JonathSpirit/Gmic/images/DS0001.PNG

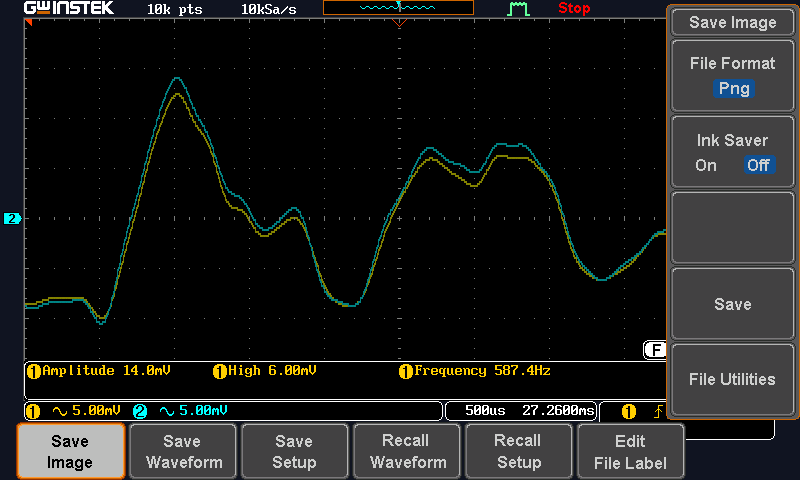
images/DS0001.PNG
