JonathSpirit/Gmic/images/DS0002.PNG

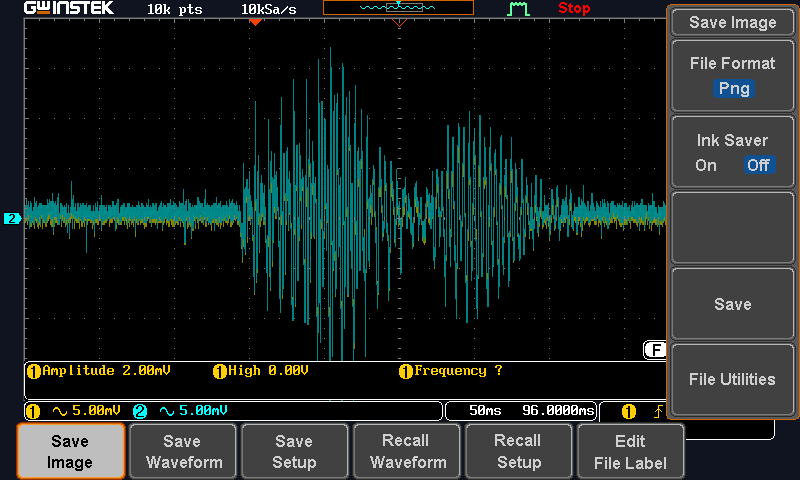
images/DS0002.PNG
