JonathSpirit/Gmic/images/DS0003.PNG

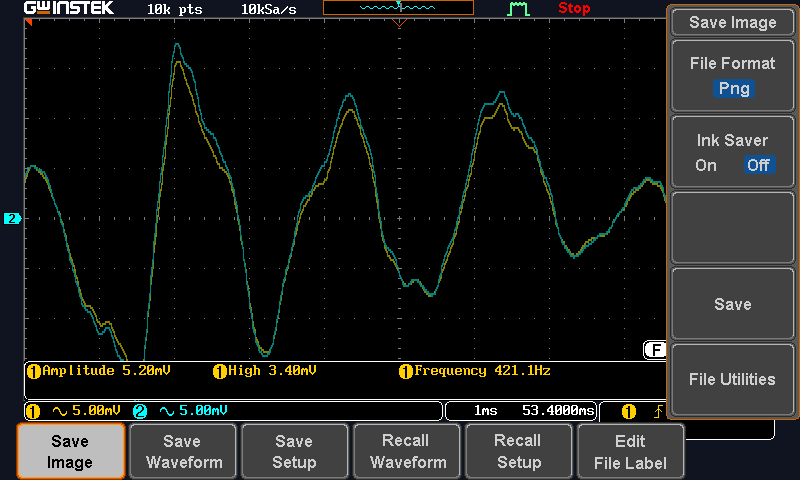
images/DS0003.PNG
