JonathSpirit/Gmic/docs/PCB_BOT.pdf

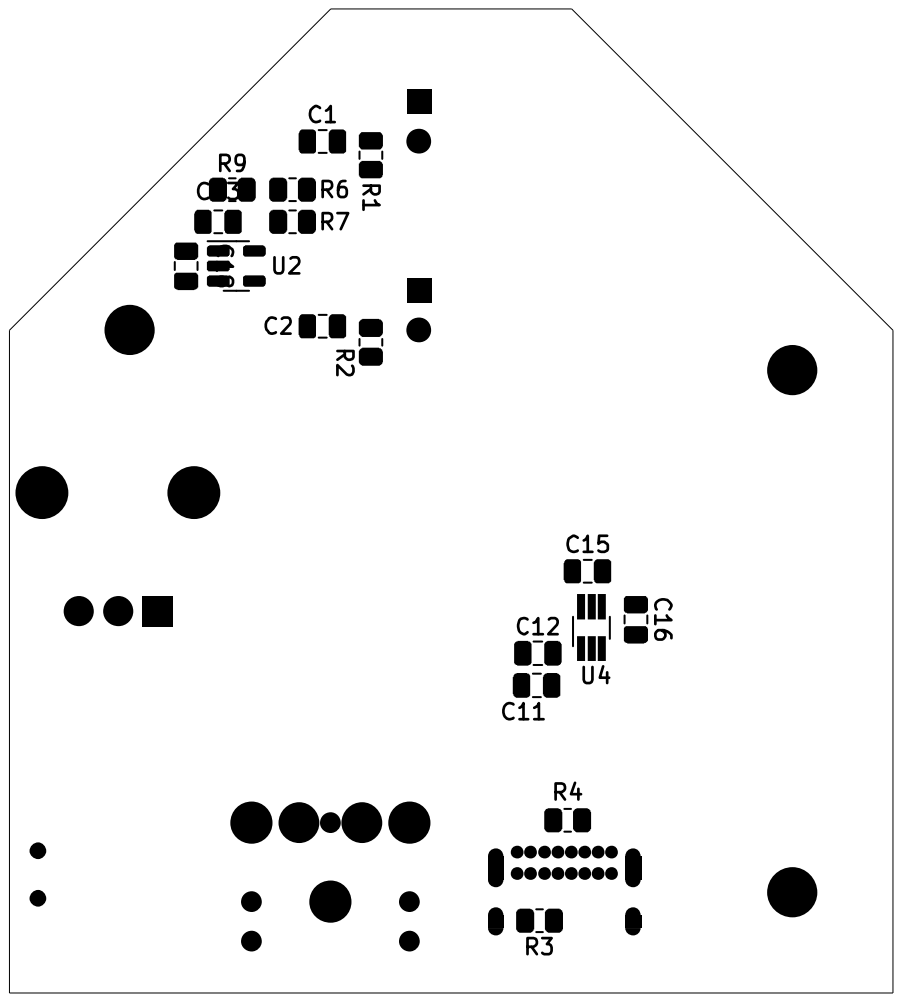
[picture p4: page 1]
