JonathSpirit/Gmic/docs/PCB_TOP.pdf

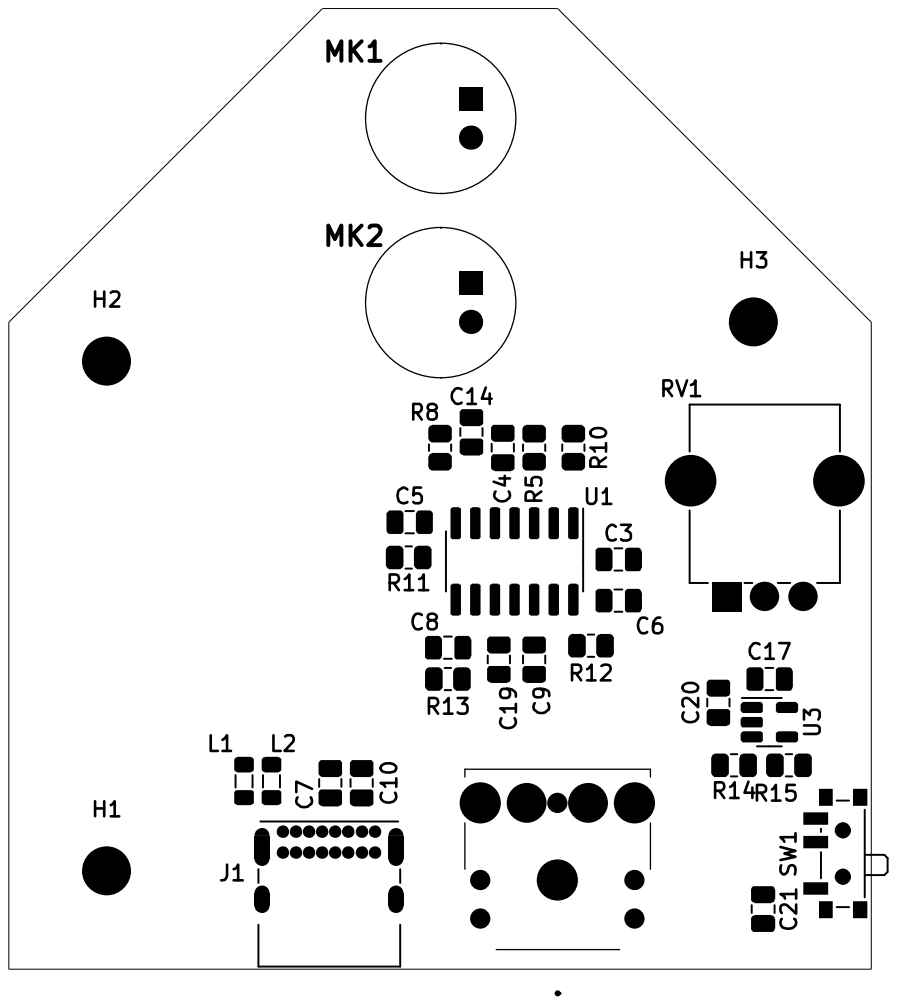
[picture p5: page 1]
