JonathSpirit/Gmic/simulations/Simulation.asc

C1: cap; 2.2µF
C2: cap; 100pF
C3: cap; 100pF
C4: cap; 100pF
C5: cap; 2.2µF
C6: cap; 2.2µF
C7: cap; 2.2µF
C8: cap; 100nF
C9: cap; 100nF
G1: g; 2.87µ
G2: g; 2.87µ
R1: res; 100k
R2: res; 100k
R3: res; 50k
R4: res; 2.2k
R5: res; 100k
R6: res; 10k
R7: res; 100k
R8: res; 10k
R9: res; 2.2k
R10: res; 80k
R11: res; 80k
R12: res; 80k
R13: res; {RPOT}
R14: res; 80k
R15: res; 80k
U1: AD8531
U2: AD8531
U3: AD8531
U4: AD8531
U5: AD8531
U6: AD8531
U7: AD8531
V3: voltage; 3.3V
V5: voltage; 62V
V6: voltage; SINE(0 0.5 10k); AC 0.5
V7: voltage; 62V
V8: voltage; SINE(0 0.45 10k); AC 0.5
Named nets: 0, Vcc, AudioCurrentIn1, AudioCurrentIn2, Vss, VOffset, AudioAverage, AudioLowPassFilter, AudioHighPassFilter, AudioOut
.tran 0 1ms 0
;ac dec 100 1 1000000
CMC-9745-44P
CMC-9745-44P
1Meg should be great, but the bandwidth of the AOP (3MHz) is limiting us
Pre-amp stage (current to voltage)
Audio averaging
Low-pass filter 20kHz, 3 order
Simple Vcc/2 reference for offset
High-pass filter 20Hz, 2 order
We already have here a ~20Hz+-20Hz high-pass at the microphone output
.step oct param RPOT 0 500k 10
