JonathSpirit/Gmic/Project_Gmic.kicad_pcb

## KiCad design Project_Gmic.kicad_pcb (2024-10-31)

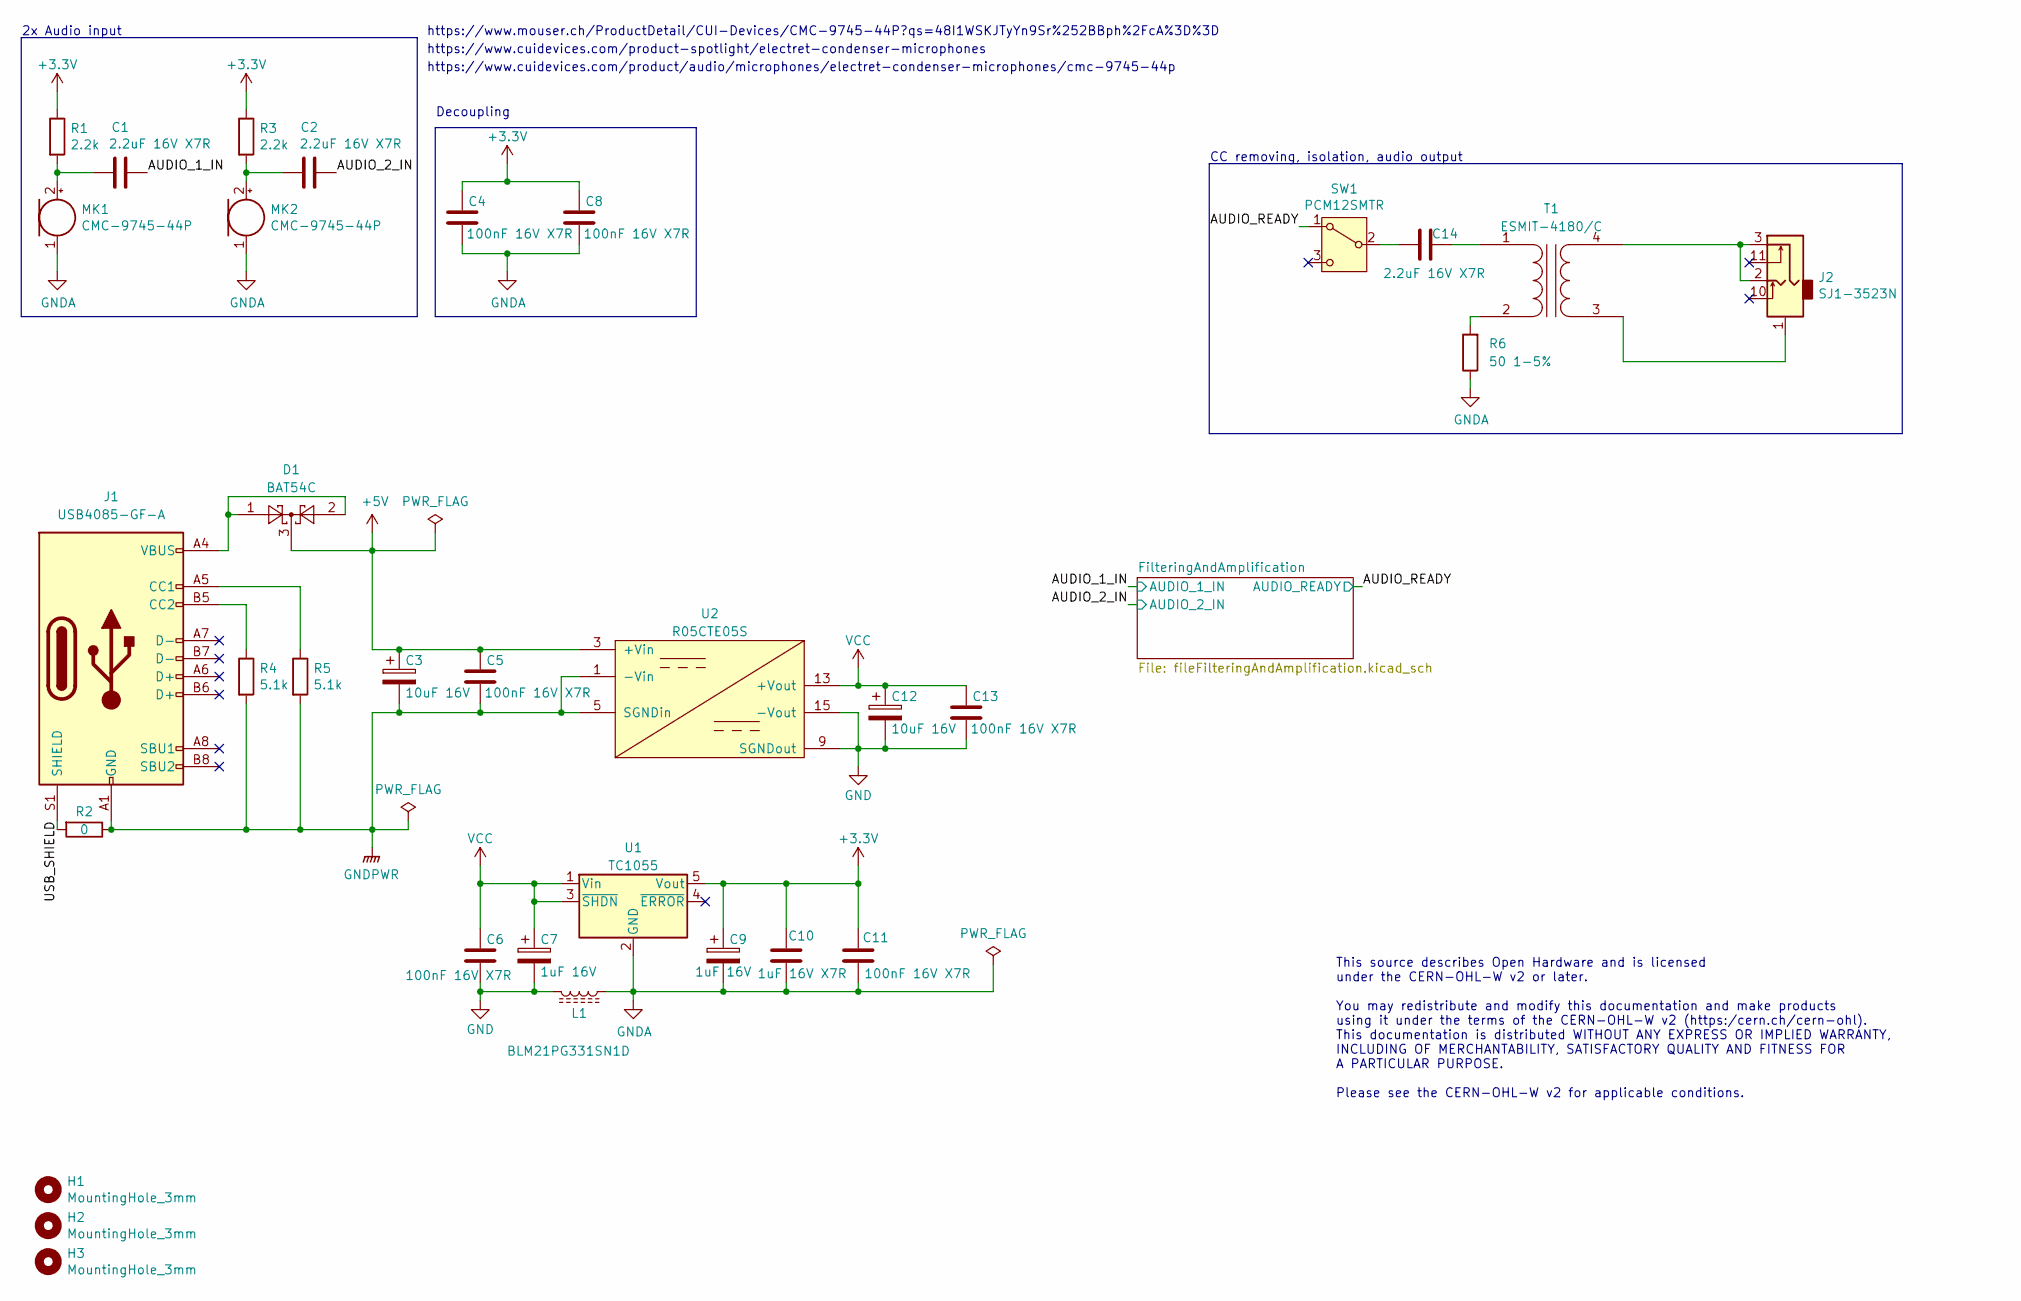
[picture p6: schematic Project_Gmic.kicad_sch, Gmic]

Parts:
C1, C2, C14: 2.2uF 16V X7R; C_0805_2012Metric
C3, C12: 10uF 16V; CP_Elec_4x5.4
C4, C5, C6, C8, C11, C13: 100nF 16V X7R; C_0805_2012Metric
C7, C9: 1uF 16V; CP_Elec_4x5.4
C10: 1uF 16V X7R; C_0805_2012Metric
D1: BAT54C; SOT-23
H1, H2, H3: MountingHole_3mm
J1: USB4085-GF-A; USB_C_Receptacle_GCT_USB4085
J2: SJ1-3523N; SJ13523N
L1: BLM21PG331SN1D; L_0805_2012Metric
MK1, MK2: CMC-9745-44P; CMC974544P
R1, R3: 2.2k; R_0805_2012Metric
R2: 0; R_0805_2012Metric
R4, R5: 5.1k; R_0805_2012Metric
R6: 50 1-5%; R_0805_2012Metric
SW1: PCM12SMTR; SW_SPDT_PCM12
T1: ESMIT-4180/C; SOP254P914X350-4N
U1: TC1055; SOT-23-5
U2: R05CTE05S; SOIC-16W_7.5x10.3mm_P1.27mm

Connections:
+3.3V: C4.1, C8.1, C9.1, C10.1, C11.1, R1.1, R3.1, U1.5 (Vout); also elsewhere on the board
+5V: C3.1, C5.1, D1.3, U2.3 (+Vin), U2.4 (+Vin)
/AUDIO_1_IN: C1.1; also elsewhere on the board
/AUDIO_2_IN: C2.1; also elsewhere on the board
/AUDIO_READY: SW1.1 (A); also elsewhere on the board
/USB_SHIELD: J1.S1 (SHIELD), R2.2
GND: C6.2, C7.2, C12.2, C13.2, L1.2, U2.9 (SGNDout), U2.11 (SGNDout), U2.12 (SGNDout), U2.15 (-Vout), U2.16 (-Vout)
GNDA: C4.2, C8.2, C9.2, C10.2, C11.2, L1.1, MK1.1 (-), MK2.1 (-), R6.1, U1.2 (GND); also elsewhere on the board
GNDPWR: C3.2, C5.2, J1.A1 (GND), J1.A12 (GND), J1.B1 (GND), J1.B12 (GND), R2.1, R4.2, R5.2, U2.1 (-Vin), U2.2 (-Vin), U2.5 (SGNDin), U2.6 (SGNDin), U2.7 (SGNDin), U2.8 (SGNDin)
unnamed: D1.1, D1.2, J1.A4 (VBUS), J1.A9 (VBUS), J1.B4 (VBUS), J1.B9 (VBUS)
unnamed: J1.A5 (CC1), R5.1
unnamed: J1.B5 (CC2), R4.1
unnamed: C1.2, MK1.2 (+), R1.2
unnamed: C2.2, MK2.2 (+), R3.2
unnamed: C14.2, SW1.2 (B)
unnamed: C14.1, T1.1 (AA)
unnamed: R6.2, T1.2 (AB)
unnamed: J2.1, T1.3 (SA)
unnamed: J2.2, J2.3, T1.4 (SB)
VCC: C6.1, C7.1, C12.1, C13.1, U1.1 (Vin), U1.3 (~SHDN), U2.13 (+Vout), U2.14 (+Vout)

Notes on the sheet:
https://www.mouser.ch/ProductDetail/CUI-Devices/CMC-9745-44P?qs=48I1WSKJTyYn9Sr%252BBph%2FcA%3D%3D
CC removing, isolation, audio output
https://www.cuidevices.com/product/audio/microphones/electret-condenser-microphones/cmc-9745-44p
Decoupling
https://www.cuidevices.com/product-spotlight/electret-condenser-microphones
2x Audio input
This source describes Open Hardware and is licensed under the CERN-OHL-W v2 or later. You may redistribute and modify this documentation and make products using it under the terms of the CERN-OHL-W v2 (https:/cern.ch/cern-ohl). This documentation is distributed WITHOUT ANY EXPRESS OR IMPLIED WARRAN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

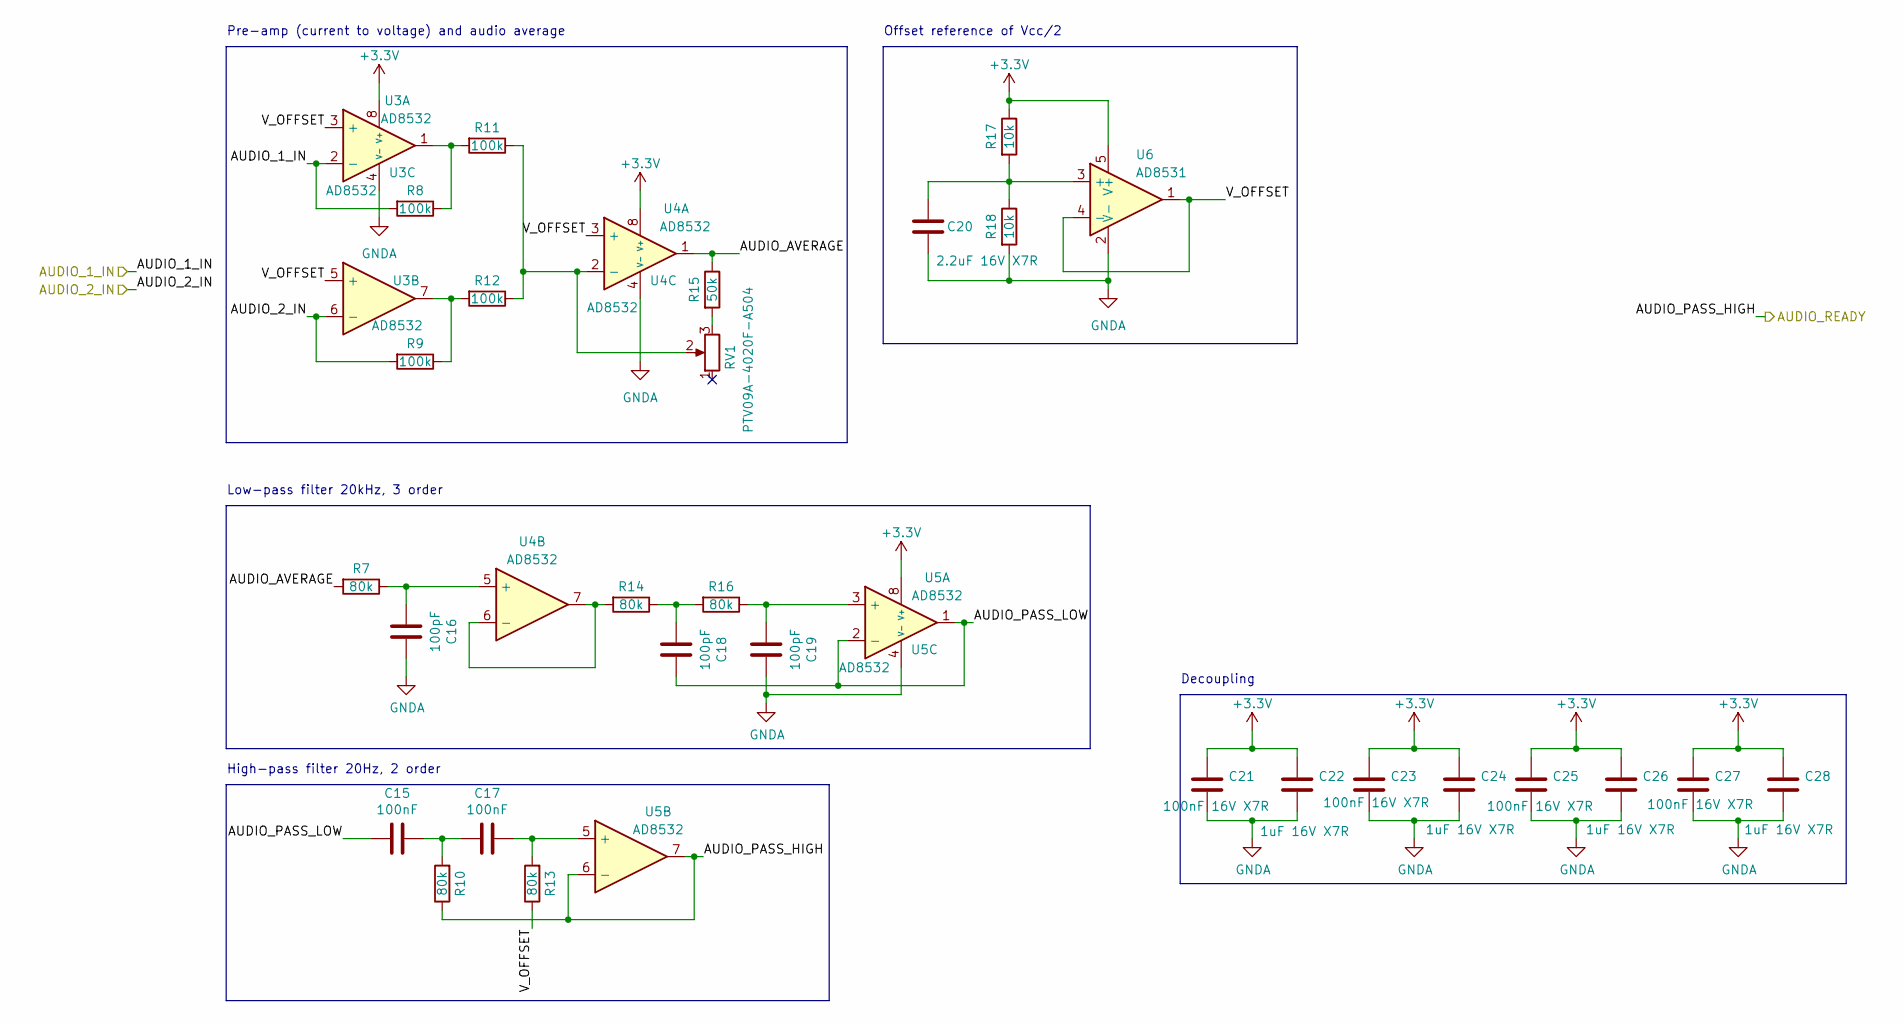
[picture p7: schematic fileFilteringAndAmplification.kicad_sch, Gmic]

Parts:
C15, C17: 100nF; C_1206_3216Metric
C16, C18, C19: 100pF; C_0805_2012Metric
C20: 2.2uF 16V X7R; C_0805_2012Metric
C21, C23, C25, C27: 100nF 16V X7R; C_0805_2012Metric
C22, C24, C26, C28: 1uF 16V X7R; C_0805_2012Metric
R7, R10, R13, R14, R16: 80k; R_0805_2012Metric
R8, R9, R11, R12: 100k; R_0805_2012Metric
R15: 50k; R_0805_2012Metric
R17, R18: 10k; R_0805_2012Metric
RV1: PTV09A-4020F-A504; PTV09A-4
U3, U4, U5: AD8532; SOIC-8_3.9x4.9mm_P1.27mm
U6: AD8531; SOT-23-5

Connections:
+3.3V: C21.1, C22.1, C23.1, C24.1, C25.1, C26.1, C27.1, C28.1, R17.1, U3.8 (V+), U4.8 (V+), U5.8 (V+), U6.5 (V+); also elsewhere on the board
/AUDIO_1_IN: R8.2, U3.2 (-); also elsewhere on the board
/AUDIO_2_IN: R9.2, U3.6 (-); also elsewhere on the board
/AUDIO_READY: R10.1, U5.6 (-), U5.7; also elsewhere on the board
/FilteringAndAmplification/AUDIO_AVERAGE: R7.2, R15.1, U4.1
/FilteringAndAmplification/AUDIO_PASS_LOW: C15.2, C18.1, U5.1, U5.2 (-)
/FilteringAndAmplification/V_OFFSET: R13.1, U3.3 (+), U3.5 (+), U4.3 (+), U6.1, U6.4 (-)
GNDA: C16.1, C19.1, C20.2, C21.2, C22.2, C23.2, C24.2, C25.2, C26.2, C27.2, C28.2, R18.2, U3.4 (V-), U4.4 (V-), U5.4 (V-), U6.2 (V-); also elsewhere on the board
unnamed: C15.1, C17.2, R10.2
unnamed: C18.2, R14.1, R16.2
unnamed: R8.1, R11.2, U3.1
unnamed: R9.1, R12.2, U3.7
unnamed: R15.2, RV1.3
unnamed: R11.1, R12.1, RV1.2, U4.2 (-)
unnamed: C16.2, R7.1, U4.5 (+)
unnamed: R14.2, U4.6 (-), U4.7
unnamed: C19.2, R16.1, U5.3 (+)
unnamed: C17.1, R13.2, U5.5 (+)
unnamed: C20.1, R17.2, R18.1, U6.3 (+)

Notes on the sheet:
Decoupling
High-pass filter 20Hz, 2 order
Pre-amp (current to voltage) and audio average
Low-pass filter 20kHz, 3 order
Offset reference of Vcc/2

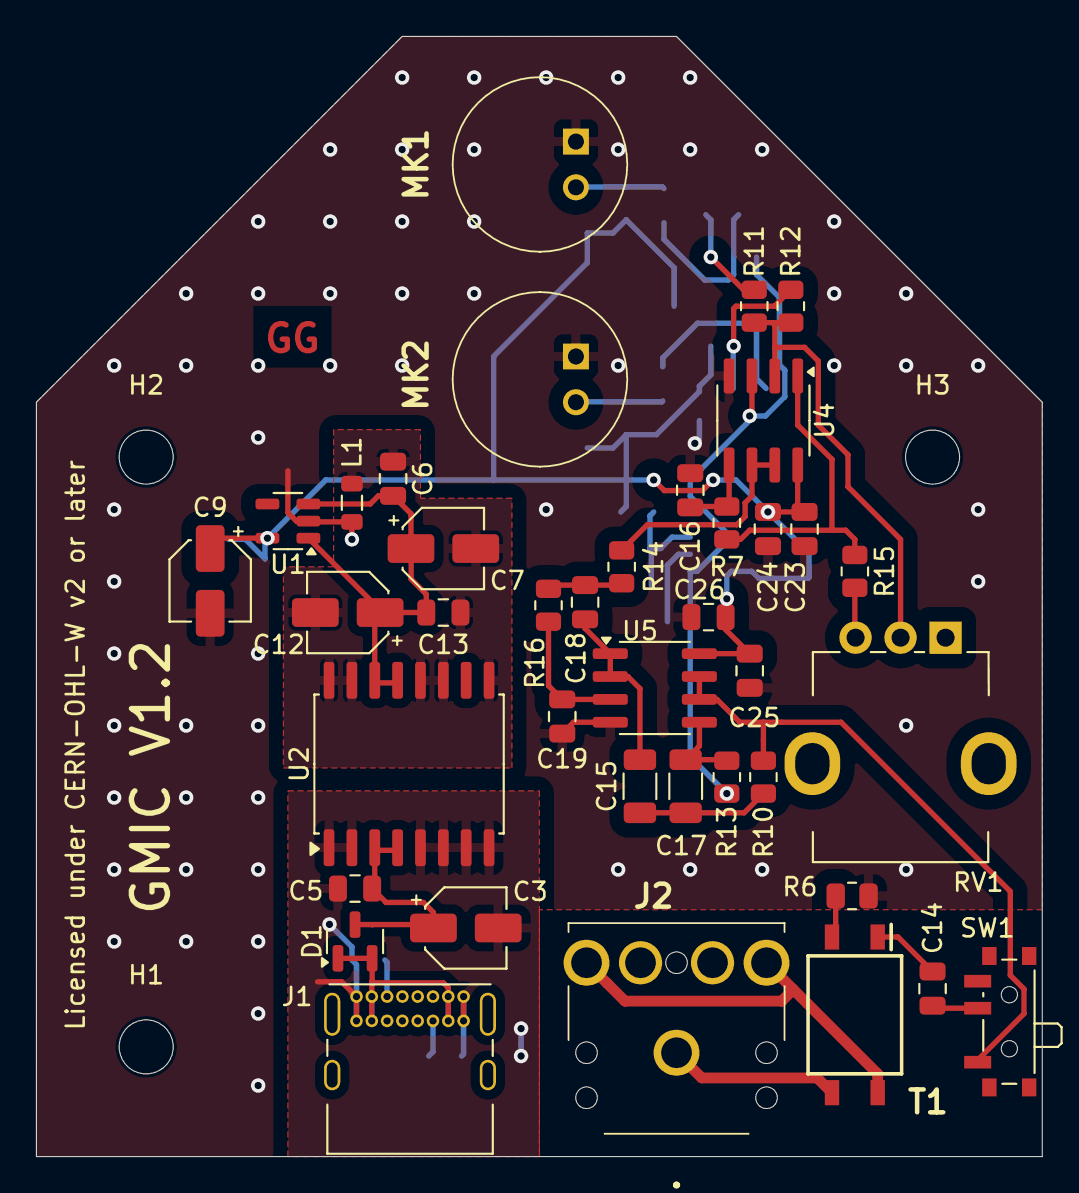
[picture p8: board Project_Gmic.kicad_pcb from above]

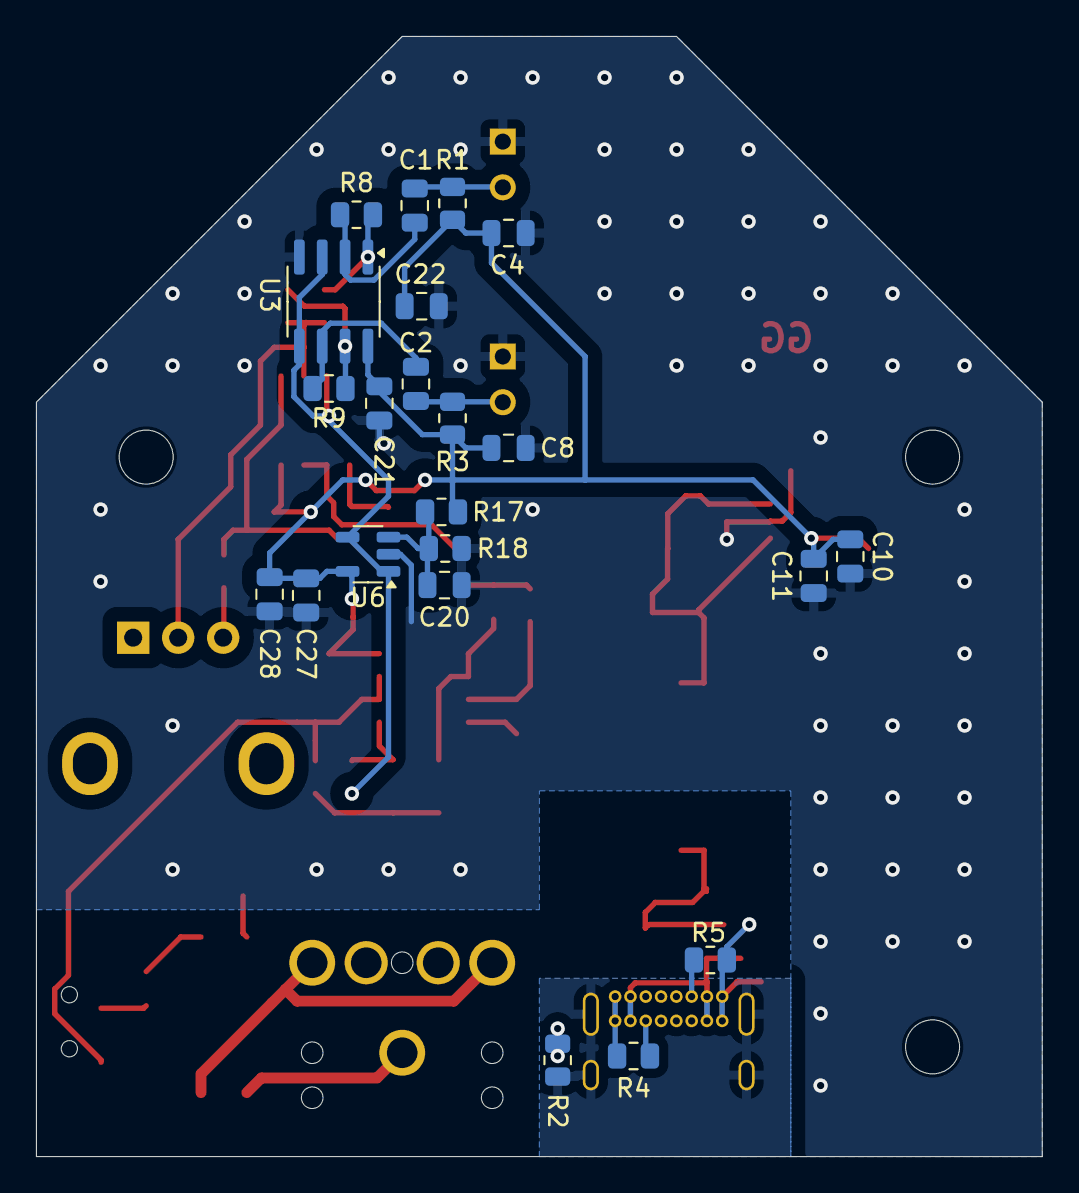
[picture p9: board Project_Gmic.kicad_pcb from below]

Board: 2 copper layers, 55.9 x 62.2 mm, 64 parts (22 on the bottom side), 34 nets.
