JonathSpirit/Gmic/(commit log)

2022-03-04 Initial WIP release
    [Project_Gmic.kicad_pcb, Project_Gmic.sch]
2022-03-05 butterworth filter, new aop, cleaning
    [Project_Gmic.sch]
2022-03-06 Set connectors, preparing usb-c
    [Project_Gmic.sch]
2022-05-13 Schematics improvement, file cleaning
    [Project_Gmic.sch]
2022-05-13 Searching for parts
    [Project_Gmic.kicad_pcb, Project_Gmic.sch]
2022-05-13 First iteration of the PCB, Rpot
    [Project_Gmic.kicad_pcb, Project_Gmic.sch]
2022-05-14 Changing the potentiometer, finishing placement and board
    [Project_Gmic.kicad_pcb, Project_Gmic.sch]
2022-05-18 BOM, finishing PCB, changing some non-available components
    [Project_Gmic.kicad_pcb, Project_Gmic.sch]
2022-06-21 Finalizing PCB, gerbert file
    [Project_Gmic-B_Cu.gbr, Project_Gmic-B_Mask.gbr, Project_Gmic-B_SilkS.gbr, Project_Gmic-Edge_Cuts.gbr, Project_Gmic-F_Cu.gbr, Project_Gmic-F_Mask.gbr, Project_Gmic-F_SilkS.gbr, Project_Gmic-NPTH.drl]
2023-03-16 moving to kicad 7, redo simulations WIP
    [Project_Gmic.kicad_pcb, Project_Gmic.kicad_sch, Project_Gmic.sch]
2023-03-16 finishing the simulation, began schematic
    [Project_Gmic.kicad_sch]
2023-03-16 updating schematic, updating BOM
    [Project_Gmic.kicad_pcb, Project_Gmic.kicad_sch]
2023-03-16 update PCB, finish placement and first routing
    [Project_Gmic.kicad_pcb]
2023-03-17 fixing pcb error, reset footprints from libs, add diode
    [Project_Gmic.kicad_pcb, Project_Gmic.kicad_sch]
2023-03-18 finishing PCB, fix serigraph, complete BOM, fix some non-sense in footprints
    [Project_Gmic.kicad_pcb]
2023-03-23 moving mounting holes, fixing POT footprint, exporting fabrication files
    [Project_Gmic-B_Cu.gbr, Project_Gmic-B_Mask.gbr, Project_Gmic-B_SilkS.gbr, Project_Gmic-B_Silkscreen.gbr, Project_Gmic-Edge_Cuts.gbr, Project_Gmic-F_Cu.gbr, Project_Gmic-F_Mask.gbr, Project_Gmic-F_SilkS.gbr]
2024-09-21 working on a v1.2, better USB isolation, audio output isolation
    [Project_Gmic.kicad_sch, fileFilteringAndAmplification.kicad_sch]
2024-10-30 placement, BOM inside kicad
    [Project_Gmic.kicad_pcb, Project_Gmic.kicad_sch, fileFilteringAndAmplification.kicad_sch]
2024-10-31 first step final
    [Project_Gmic.kicad_pcb, Project_Gmic.kicad_sch, fileFilteringAndAmplification.kicad_sch]
2025-03-14 generate gerbert files
    [Project_Gmic-B_Cu.gbr, Project_Gmic-B_Mask.gbr, Project_Gmic-B_Silkscreen.gbr, Project_Gmic-Edge_Cuts.gbr, Project_Gmic-F_Cu.gbr, Project_Gmic-F_Mask.gbr, Project_Gmic-F_Silkscreen.gbr, Project_Gmic-NPTH.drl]
