JonathSpirit/Gmic/(notices)

Notices in the files:
Project_Gmic.kicad_sch:
Copyright Guillaume Guillet 2024
Licensed under CERN-OHL-W v2 or later
